mnorden81/CRSF-Multiswitch-ESP32-S3/docs/Projektbeschreibung.docx

# RC-Multiswitch-ESP32-S3

Projektbeschreibung, Stand 18.10.2026, Hardware v0.4 (PCB vom C3 uebertragen)

# Zweck

RC-Multiswitch mit 8 Schaltkanaelen auf einem Waveshare ESP32-S3-Zero.

Gleiche Funktion wie die C3-Variante, aber mit dem ESP32-S3-Zero und einem dritten UART. Das PCB wurde vom C3-Layout uebernommen, die Leitungen am ESP32 sind neu verlegt (DRC steht noch aus).

# Merkmale

- 8 Schaltkanaele ueber ULN2803A, Kontroll-LED je Kanal
- UART A (Eingang), UART B und UART C (Weiterleitung/Erweiterung)
- Versorgung des ESP32 aus +5 V des Empfaengers, Last getrennt mit 5-12 V
- Eigener THT-Footprint fuer den S3-Zero (nur 2x9 Header)

# Hardware

Board: Waveshare ESP32-S3-Zero

## Last und Treiber

- Lastspannung 5-12 V (VLOAD) an CN2 (JST PH 2), TVS-Diode P6KE18A als Schutz.
- Treiber ULN2803A, 8 Kanaele, max. 500 mA je Kanal (Verlustleistung des ULN2803A bei mehreren Kanaelen beachten).
- R9-R16 (THT 1/4 W) zwischen ULN-Ausgang und Stiftleiste J1: Es ist kein Wert vorgegeben. Der Anwender muss die Widerstaende selbst passend zu Verbraucher und Lastspannung (5-12 V) auslegen, Strom und Verlustleistung beachten.
- R1-R8 und LED1-LED8 (3 mm) als Kontroll-LED je Kanal, vom Steuersignal Sn (3,3 V) gegen GND. Auch hier legt der Anwender die Werte selbst fest. Eine Empfehlung fuer die Kontroll-LEDs ist auf der Platine aufgedruckt.
- Keine Pulldowns und keine Widerstaende in den UART-Leitungen. Der ESP32 wird aus +5 V von CN1 (BEC/Empfaenger) versorgt.

## GPIO-Belegung

Funktion | GPIO
S0..S7 | IO11, IO4, IO5, IO6, IO10, IO9, IO8, IO7
UART A (CN1, Eingang) | TX IO43, RX IO44 (UART0)
UART B (J5) | TX IO13, RX IO12
UART C (J6) | TX IO2, RX IO1
Frei | IO3 (Strapping), IO14-IO16 (Loetpads)

## Anschluesse

- CN1, J5, J6: UART A/B/C als JST-GH 4 (Footprint BM04B-GHS-TBT)
- CN2 Last 5-12 V (JST PH 2, max. ca. 2 A je Kontakt)
- J1 Ausgaenge S0..S7

## Hinweise

- UART A liegt auf UART0: beim Booten gibt das ROM ein Log auf IO43 aus.
- Empfehlung LED-Vorwiderstaende R1-R8 bei 3,3 V (ca. 5 mA, auch auf der Platine aufgedruckt): Rot/Gelb 270 R, Gruen 220 R, Blau/Weiss 56 R.
- Footprint ESP32-S3-Zero_THT: 2x9, 2,54 mm, Reihenabstand 15,24 mm. Vor dem Layout 1:1 am echten Board pruefen.

# Firmware (v4.01)

- Arduino-Sketch firmware/RC_Multiswitch, gleicher Quellcode fuer C3 und S3 (Board wird automatisch erkannt). Basis: MultiSwitch_ESP32_V3 v3.12.
- CRSF auf UART A, wahlweise SBUS. Modulkette ueber UART B (und UART C beim S3), Router mit CRC-Pruefung und Sendewarteschlange je Port.
- Jedes Modul der Kette hat eine eigene Adresse (0-15) und ist ueber Lua am Sender und ueber die Web-UI einzeln einstellbar.
- BOOT-Taster 3 s: WLAN-AP ein/aus. Status-LED (nur S3): aus, 500 ms, schnell bei Failsafe, Doppelblitz bei doppelter Adresse.

# Projektstruktur

- hardware/: KiCad-Projekt (Schaltplan, PCB, PDF, eigene Footprints)
- firmware/: Firmware v4.01 (Arduino-Sketch, Details in firmware/README.md)
- docs/: diese Projektbeschreibung
- README.md: Kurzfassung fuer GitHub

# Stand

- Hardware: Schaltplan fertig, PCB vom C3 uebernommen und an U1 neu verlegt. DRC in KiCad steht noch aus, J6 nur vorlaeufig platziert.
- Firmware: v4.01 kompiliert fuer C3 und S3, noch nicht auf Hardware getestet.

# Offene Punkte

- DRC in KiCad ausfuehren (an U1 sind laut PCB-Datei alle Anschluesse verlegt)
- Platzierung von J6 (UART C) festlegen
- Footprint am echten Board pruefen
- Firmware auf Hardware testen (Einzelmodul und Kette mit 2-3 Modulen)

RC-Multiswitch-ESP32-S3 | Seite
