mnorden81/CRSF-Multiswitch-ESP32-S3/hardware/RC-Multiswitch-ESP32-S3.pdf

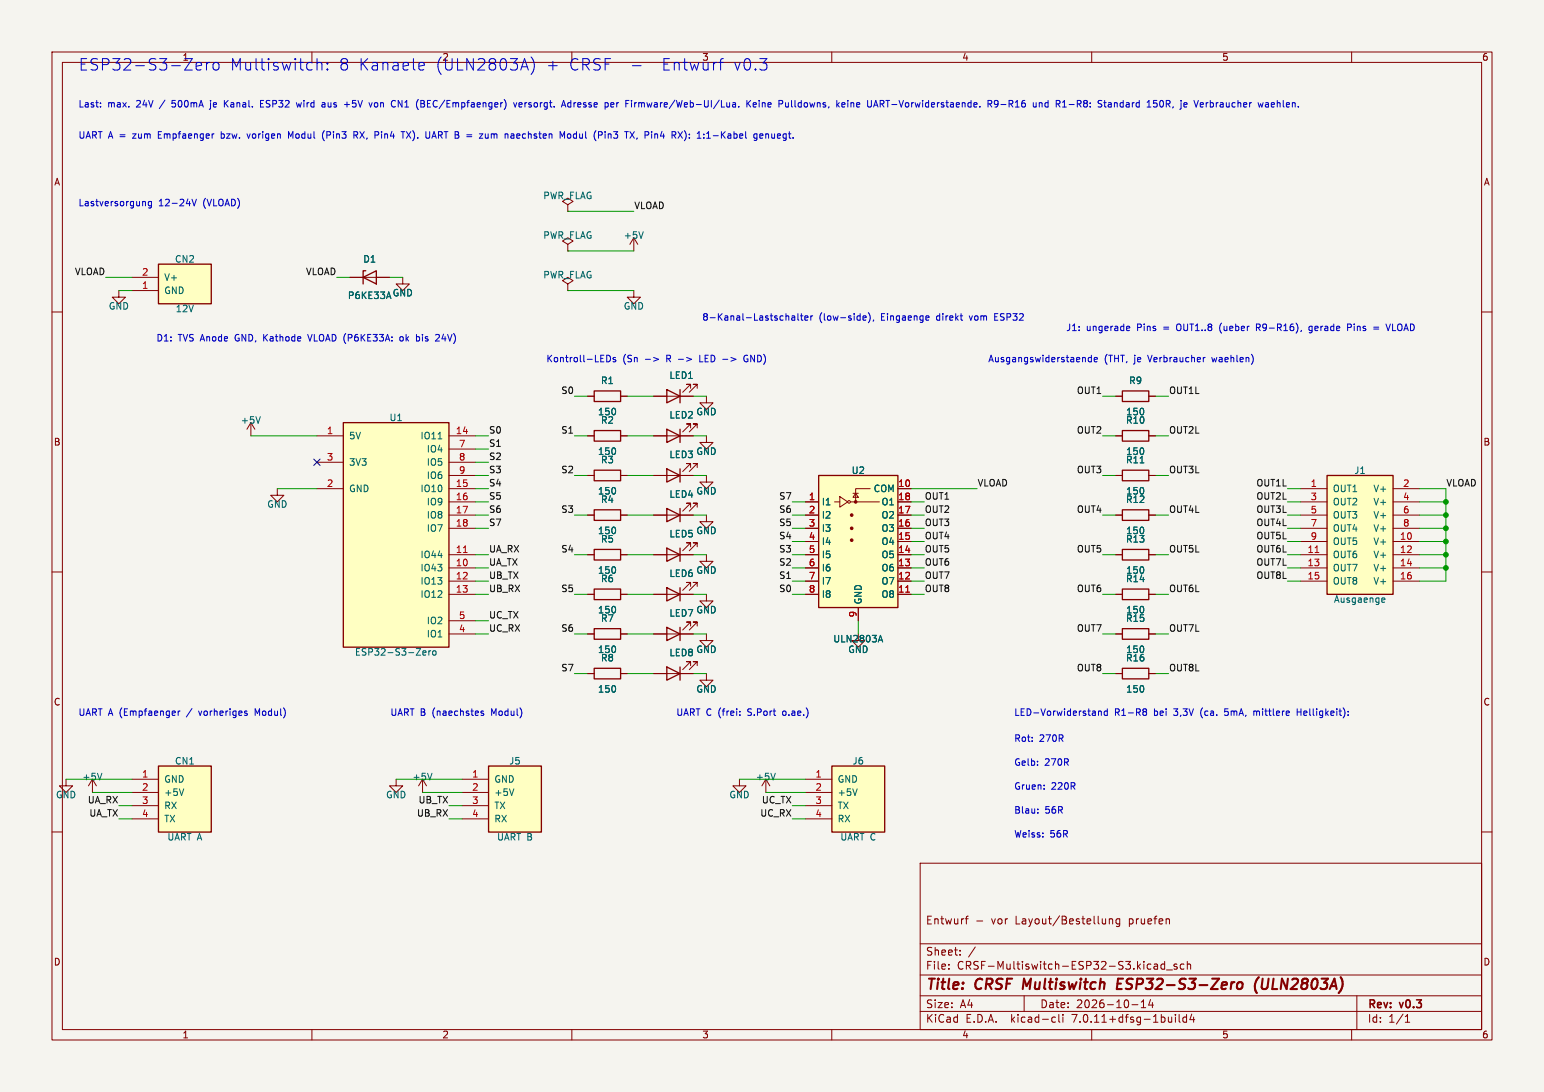
[picture p1: page 1]
