mnorden81/CRSF-Multiswitch-ESP32-S3/hardware/RC-Multiswitch-ESP32-S3.kicad_pcb

## KiCad design hardware/RC-Multiswitch-ESP32-S3.kicad_pcb (2026-10-20)

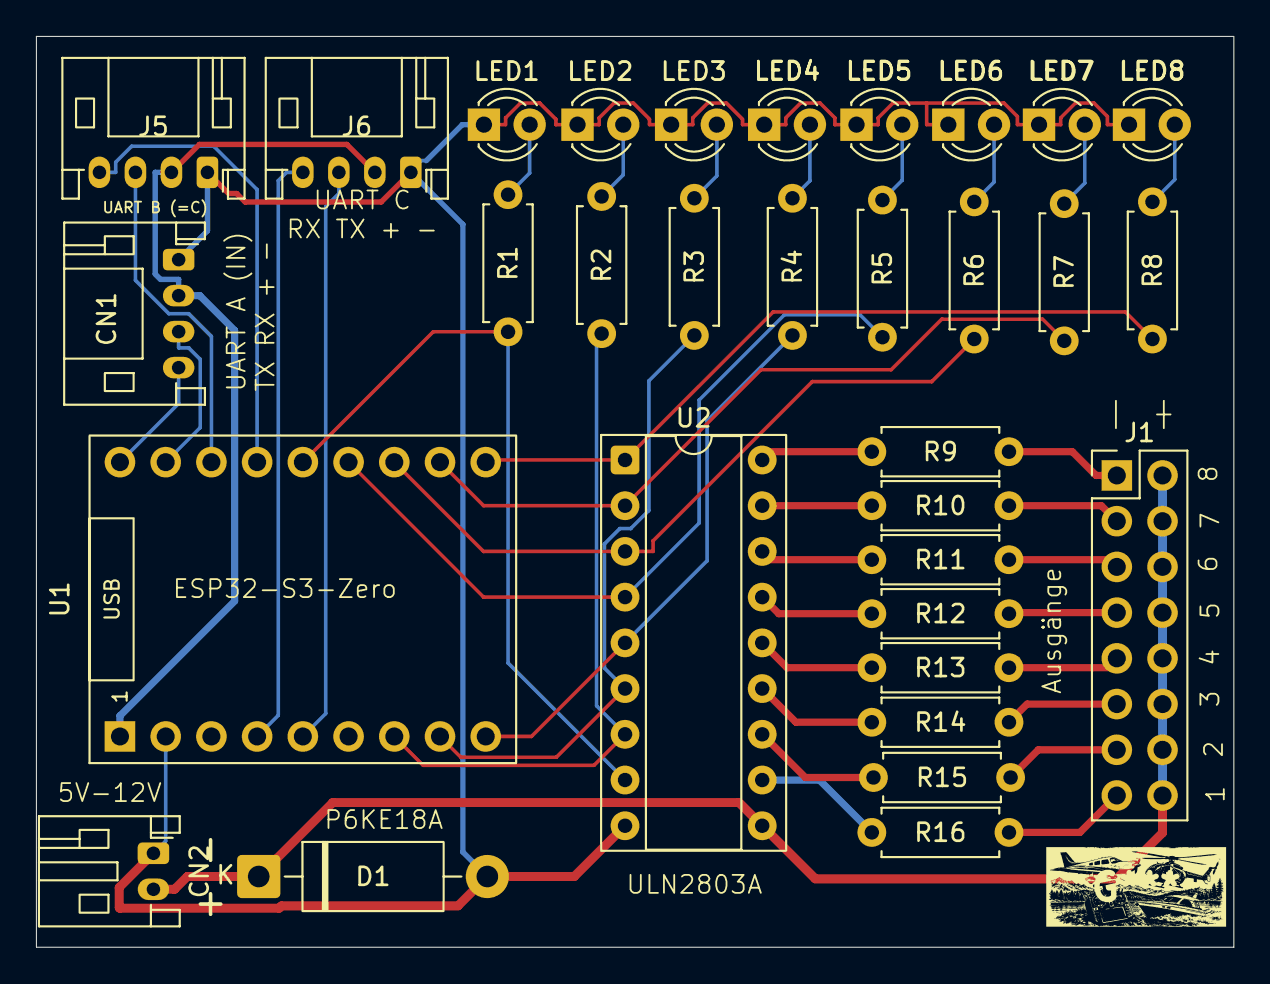
[picture p2: board RC-Multiswitch-ESP32-S3.kicad_pcb from above]

Board: 2 copper layers, 66.5 x 50.6 mm, 32 parts (0 on the bottom side), 41 nets.

Parts:
CN1: UART A; JST_PH_S4B-PH-K_1x04_P2.00mm_Horizontal
CN2: 5-12V; JST_PH_S2B-PH-K_1x02_P2.00mm_Horizontal
D1: P6KE18A; D_DO-15_P12.70mm_Horizontal
J1: Ausgaenge; PinHeader_2x08_P2.54mm_Vertical
J5: J5_UART B; JST_PH_S4B-PH-K_1x04_P2.00mm_Horizontal
J6: UART C; JST_PH_S4B-PH-K_1x04_P2.00mm_Horizontal
LED1, LED2, LED3, LED4, LED5, LED6, LED7, LED8: LED; LED_D3.0mm
R1, R2, R3, R4, R5, R6, R7, R8, R9, R10, R11, R12, R13, R14, R15, R16: R; R_Axial_DIN0207_L6.3mm_D2.5mm_P7.62mm_Horizontal
U1: ESP32-S3-Zero; ESP32-S3-Zero_THT
U2: ULN2803A; DIP-18_W7.62mm_Socket

Connections:
+5V: CN1.2 (+5V), J5.2 (+5V), J6.2 (+5V), U1.1 (5V)
/OUT1: R9.1, U2.18 (O1)
/OUT1L: J1.1 (OUT1), R9.2
/OUT2: R10.1, U2.17 (O2)
/OUT2L: J1.3 (OUT2), R10.2
/OUT3: R11.1, U2.16 (O3)
/OUT3L: J1.5 (OUT3), R11.2
/OUT4: R12.1, U2.15 (O4)
/OUT4L: J1.7 (OUT4), R12.2
/OUT5: R13.1, U2.14 (O5)
/OUT5L: J1.9 (OUT5), R13.2
/OUT6: R14.1, U2.13 (O6)
/OUT6L: J1.11 (OUT6), R14.2
/OUT7: R15.1, U2.12 (O7)
/OUT7L: J1.13 (OUT7), R15.2
/OUT8: R16.1, U2.11 (O8)
/OUT8L: J1.15 (OUT8), R16.2
/S0: R1.1, U1.14 (IO11), U2.8 (I8)
/S1: R2.1, U1.7 (IO4), U2.7 (I7)
/S2: R3.1, U1.8 (IO5), U2.6 (I6)
/S3: R4.1, U1.9 (IO6), U2.5 (I5)
/S4: R5.1, U1.15 (IO10), U2.4 (I4)
/S5: R6.1, U1.16 (IO9), U2.3 (I3)
/S6: R7.1, U1.17 (IO8), U2.2 (I2)
/S7: R8.1, U1.18 (IO7), U2.1 (I1)
/UA_RX: CN1.3 (RX), U1.11 (IO44)
/UA_TX: CN1.4 (TX), U1.10 (IO43)
/UB_RX: J5.4 (RX), U1.13 (IO12)
/UB_TX: J5.3 (TX), U1.12 (IO13)
/UC_RX: J6.4 (RX), U1.4 (IO1)
/UC_TX: J6.3 (TX), U1.5 (IO2)
/VLOAD: CN2.2 (V+), D1.1 (K), J1.2 (V+), J1.4 (V+), J1.6 (V+), J1.8 (V+), J1.10 (V+), J1.12 (V+), J1.14 (V+), J1.16 (V+), U2.10 (COM)
GND: CN1.1 (GND), CN2.1 (GND), D1.2 (A), J5.1 (GND), J6.1 (GND), LED1.1 (K), LED2.1 (K), LED3.1 (K), LED4.1 (K), LED5.1 (K), LED6.1 (K), LED7.1 (K), LED8.1 (K), U1.2 (GND), U2.9 (GND)
unnamed: LED1.2 (A), R1.2
unnamed: LED2.2 (A), R2.2
unnamed: LED3.2 (A), R3.2
unnamed: LED4.2 (A), R4.2
unnamed: LED5.2 (A), R5.2
unnamed: LED6.2 (A), R6.2
unnamed: LED7.2 (A), R7.2
unnamed: LED8.2 (A), R8.2
