mnorden81/CRSF-Multiswitch-ESP32-S3/firmware/RC_Multiswitch/crsf_esp32.h

#ifndef CRSF_H
#define CRSF_H

#include <Arduino.h>
#include "crsf_esp32_protocol.h"

#define CRSF_MAX_CHANNELS 16
#define CRSF_PACKET_SIZE 64

#define BAUD_RATE 420000
#define CHANNEL_MASK 0x07FF

// v4.01: CRSF-Router fuer Modulketten (Spezifikation Kapitel 4)
#define CRSF_ROUTER_QUEUE 8      // Sendewarteschlange je Port (Frames)
#define CRSF_UART_RX_BUF  1024   // UART-Empfangspuffer (Bytes)
#define CRSF_UART_TX_BUF  512    // UART-Sendepuffer (Bytes)

// Ein CRSF-Port des Routers: Empfangs-Parser + Sendewarteschlange.
struct CrsfPort {
    HardwareSerial* ser = nullptr;
    // Parser (Zustand bleibt ueber Aufrufe erhalten)
    uint8_t rx[CRSF_PACKET_SIZE];
    uint8_t rxIdx = 0;
    uint8_t rxLen = 0;
    // Sendewarteschlange (Ringpuffer ganzer Frames)
    uint8_t q[CRSF_ROUTER_QUEUE][CRSF_PACKET_SIZE];
    uint8_t qLen[CRSF_ROUTER_QUEUE];
    uint8_t qHead  = 0;
    uint8_t qCount = 0;
};

class CRSF
{
public:

    CRSF();
    void init_crsf(HardwareSerial *serialPort, uint8_t rxPin, uint8_t txPin);
    void read_packets(uint8_t debug);

    // ── Router (NEU v4.01) ──────────────────────────────────────────────
    // portC darf nullptr sein (C3 hat keinen UART C). Nach init_crsf() aufrufen.
    void init_router(HardwareSerial* portB, uint8_t bRx, uint8_t bTx,
                     HardwareSerial* portC, uint8_t cRx, uint8_t cTx);
    // B/C lesen, nach A weiterleiten, Warteschlangen abarbeiten. Jeden Loop.
    void route_packets();
    uint32_t getFwdDown()    const { return fwdDown; }    // A -> B/C
    uint32_t getFwdUp()      const { return fwdUp; }      // B/C -> A
    uint32_t getFwdDropped() const { return fwdDropped; } // Warteschlange voll
    uint32_t getDownCrcErrors() const { return downCrcErrors; }
    // Device-Info mit eigener Adresse von B/C gesehen = doppelte Adresse
    bool     isDuplicateAddress() const { return duplicateAddress; }
    void send_packets(byte* buffer, size_t length, uint8_t debug);

    void send_rc_channels_packed();
    void send_ping();
    // paramVersion: CRSF "Parameter Version Number" - Default 0 nur fuer
    // Faelle ohne eigene Zaehlung; der Haupt-Aufruf (MultiSwitch_ESP32_V3.ino)
    // uebergibt seit v2.03 die Firmware-Version, siehe dortigen Kommentar
    // (uebernommen aus dem Soundmodul-Projekt, ESP32-RC-Sound v7.18).
    void send_device_info(const char* name, uint8_t parameter, uint8_t paramVersion = 0);
    void send_param_response_CRSF_UINT8(uint8_t param_id, uint8_t parent, const char* name, uint8_t val, uint8_t min, uint8_t max, const char* unit);
    void send_param_response_CRSF_FLOAT(uint8_t param_id, uint8_t parent,  const char* name, uint32_t val, uint32_t min, uint32_t max, uint32_t default_val, uint8_t decimal_point, uint32_t step_size, const char* unit);
    void send_param_response_CRSF_TEXT_SELECTION(uint8_t param_id, uint8_t parent,  const char* name, const char* options, uint8_t val, uint8_t min, uint8_t max);
    void send_param_response_CRSF_STRING(uint8_t param_id, uint8_t parent,  const char* name, const char* value, uint8_t val, uint8_t max_length);
    void send_param_response_CRSF_FOLDER(uint8_t param_id, uint8_t parent, const char* name, std::initializer_list<uint8_t> children);
    void send_param_response_CRSF_INFO(uint8_t param_id, uint8_t parent,  const char* name, const char* info);

    void send_tele_GPS(int32_t latitude, int32_t longitude, uint16_t groundspeed, uint16_t heading, uint16_t altitude, uint8_t satellites);
    void send_tele_Battery_Sensor(uint16_t voltage, uint16_t current, uint32_t capacity_used, uint8_t remaining);
    void send_tele_Vario(uint16_t v_speed);   
    void send_tele_Baro_Altitude(int32_t altitude_dm, int16_t vertical_speed_cm_s);
    void send_tele_Airspeed(uint16_t speed);
    void send_tele_RPM(uint8_t rpm_source_id, std::initializer_list<int32_t> rpm_value);
    void send_tele_Temp(uint8_t temp_source_id, std::initializer_list<int32_t> temperature);
    void send_tele_Voltages(uint8_t voltage_source_id, std::initializer_list<int32_t> voltage_values);
    void send_tele_Attitude(int16_t pitch, int16_t roll, int16_t yaw);

    void send_command_MWSET(uint8_t adress, uint8_t state);
    void send_command_MWSET4(uint8_t adress, uint8_t stateH, uint8_t stateL);
    void send_command_MWSET4M(uint8_t adress_1, uint8_t stateH_1, uint8_t stateL_1, uint8_t adress_2, uint8_t stateH_2, uint8_t stateL_2);
    void send_command_MWPROP(uint8_t adress, uint8_t channel, uint8_t duty );

    void send_param(uint8_t parameter_number, uint8_t data);
    void read_param(uint8_t parameter_number, uint8_t parameter_chunk_number);

    void send_command(uint8_t command_id, std::initializer_list<uint8_t> payload);

    uint16_t get_crfs_channels(uint8_t ch) const { return channels[ch]; }
    uint8_t get_crfs_buffer(uint8_t ch) const { return crfs_buffer[ch]; }
    // Separater Puffer fuer MWSET-Kommandos: beim Empfang gesichert (gegen Ueberschreiben durch Folge-Frames)
    uint8_t get_cmd_buffer(uint8_t ch) const { return cmdBuffer[ch]; }

    bool getDeviceInfoReplyPending() const { return deviceInfoReplyPending; }
    bool getDeviceEntryReplyPending() const { return deviceEntryReplyPending; }
    bool getDeviceReadReplyPending() const { return deviceReadReplyPending; }
    bool getDeviceWriteReplyPending() const { return deviceWriteReplyPending; }
    bool getDeviceCommandReplyPending() const { return deviceCommandReplyPending; }
    uint8_t getPingSource()      const { return pingSource; }
    uint8_t getParamReadIndex()  const { return paramReadIndex; }
    uint8_t getParamWriteIndex() const { return paramWriteIndex; }
    uint8_t getParamWriteValue() const { return paramWriteValue; }
    uint8_t getParamReadSource() const { return paramReadSource; }
    // Eigene CRSF-Geraeteadresse (0xC0..0xCF, abgeleitet aus der WM-Adresse) – uebernommen aus v1.24
    void          setDeviceAddress(uint8_t a) { deviceAddress = a; }
    uint8_t       getDeviceAddress() const { return deviceAddress; }
    unsigned long getPingTime()      const { return pingReceivedTime; }
    void addTxEcho(uint16_t n) { txEchoBytes += n; }

    void setDeviceInfoReplyPending(bool newValue);
    void setDeviceEntryReplyPending(bool newValue);
    void setDeviceReadReplyPending(bool newValue);
    void setDeviceWriteReplyPending(bool newValue);
    void setDeviceCommandReplyPending(bool newValue);

    void set_crsf_channel(uint8_t ch, uint16_t value);

    // ── Diagnose-Zaehler (immer aktiv) ──────────────────────────────────
    // v2.00, uebernommen aus Soundmodul-Projekt: macht "geht nicht" auf der
    // Debug-Seite direkt sichtbar (kommen ueberhaupt Bytes an? gueltige
    // Frames? CRC-Fehler? wird ueberhaupt gepingt?), ohne Seriell-Monitor.
    uint32_t getRawBytesRx()  const { return rawBytesRx; }
    uint32_t getValidFrames() const { return validFramesRx; }
    uint32_t getCrcErrors()   const { return crcErrorsRx; }
    uint32_t getDevicePings() const { return devicePingsRx; }
    uint32_t getParamReads()  const { return paramReadsRx; }
    uint32_t getParamWrites() const { return paramWritesRx; }
    // v4.00: Zeitpunkt (millis) des letzten RC_CHANNELS_PACKED-Frames,
    // 0 = noch keiner. Basis fuer das LED-Muster "Frames da, aber kein RC-Link".
    unsigned long getLastRcFrameMs() const { return lastRcFrameMs; }

private:
    void updateChannels();
    void updateLink_Statistics();
    void updateDevice_Info();
    void print_channels();
    void crsfDataReceive();

    // Router (v4.01)
    static bool isSyncByte(uint8_t b);
    bool parseByte(CrsfPort& p, uint8_t data);   // true = gueltiger Frame in p.rx
    void routeFromA(const uint8_t* f, uint8_t n);
    void routeFromDown(CrsfPort& p);
    void enqueue(CrsfPort& p, const uint8_t* f, uint8_t n);
    void serviceQueue(CrsfPort& p);
    CrsfPort portA_, portB_, portC_;   // portA_ nur Sendewarteschlange
    bool     routerActive  = false;
    uint32_t fwdDown       = 0;
    uint32_t fwdUp         = 0;
    uint32_t fwdDropped    = 0;
    uint32_t downCrcErrors = 0;
    bool     duplicateAddress = false;
    // Parser-Zustand UART A (v4.01: bleibt ueber Aufrufe erhalten)
    uint8_t  rxIdxA = 0;
    uint8_t  rxLenA = 0;

    bool deviceInfoReplyPending;
    bool deviceEntryReplyPending;
    bool deviceReadReplyPending;
    bool deviceWriteReplyPending;
    bool deviceCommandReplyPending;

    uint8_t crfs_buffer[CRSF_PACKET_SIZE];
    uint8_t cmdBuffer[CRSF_PACKET_SIZE] = {0}; // gesicherte Kopie des letzten MWSET-Kommandos
    uint8_t pingSource    = 0xEA;  // Source des letzten DEVICE_PING
    uint16_t txEchoBytes  = 0;     // Gesendete Bytes zum Ueberspringen (Echo-Filter)
    uint8_t paramReadIndex  = 0;   // Angefragter Parameter-Index
    uint8_t paramWriteIndex = 0;   // Zu schreibender Parameter-Index
    uint8_t paramWriteValue = 0;   // Zu schreibender Wert
    uint8_t paramReadSource  = 0xEF; // Source des PARAMETER_READ -> Destination der Antwort
    uint8_t deviceAddress = CRSF_ADDRESS_FLIGHT_CONTROLLER; // eigene CRSF-Adresse (0xC0..0xCF aus WM-Adresse; Default 0xC8)
    unsigned long pingReceivedTime = 0; // Zeitpunkt des letzten Broadcast-Ping (fuer Slot-Delay)
    uint16_t channels[CRSF_MAX_CHANNELS];

    // Diagnose-Zaehler (siehe Getter oben) - v2.00
    uint32_t rawBytesRx    = 0; // jedes vom UART gelesene Byte
    uint32_t validFramesRx = 0; // Frames mit gueltiger CRC (== "frischer Frame da")
    uint32_t crcErrorsRx   = 0; // Frames mit CRC-Fehler
    uint32_t devicePingsRx = 0; // empfangene DEVICE_PING (an uns/Broadcast)
    uint32_t paramReadsRx  = 0; // empfangene PARAMETER_READ (an uns/Broadcast)
    unsigned long lastRcFrameMs = 0; // v4.00, siehe getLastRcFrameMs()
    uint32_t paramWritesRx = 0; // empfangene PARAMETER_WRITE (an uns/Broadcast)
};

#endif
