mnorden81/CRSF-Multiswitch-ESP32-S3/(commit log)

2026-10-16 Ausgangsstand aus KiCad-ZIP vom 2026-10-15
    Hardware nach hardware/, leerer Ordner firmware/, README und .gitignore.
    Claude-Session: https://claude.ai/code/session_017Lns5pPfH18AXUiHEWcrs9
    [CRSF-Multiswitch-ESP32-S3.kicad_pcb, CRSF-Multiswitch-ESP32-S3.kicad_sch]
2026-10-16 Projektbeschreibung in README und docs/Projektbeschreibung.docx
    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
2026-10-16 Hardware-Beschreibung und Firmware-Spezifikation nach docs/
    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
2026-10-16 Firmware v4.00 Schritt 1: Board-Konfiguration C3/S3
    Gleicher Stand wie CRSF-Multiswitch-ESP32-C3 PR #1 (Basis V3 v3.12):
    board_config.h fuer C3/S3, CRSF und SBUS auf UART A, WifiPin entfernt,
    C3-Ausgang 7/8 digital, S3-Status-LED als WS2812, Build fuer C3 und S3.
    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
2026-10-16 Status-LED: Muster nach Spezifikation Kapitel 6
    aus = kein Signal, 500 ms = OK, 100 ms schnell = Failsafe bzw. kein
    RC-Link (CRSF: > 1 s kein Kanal-Frame oder Uplink-LQ 0, SBUS:
    Failsafe-Flag), Doppelblitz = Konfigurationsfehler (g_ledConfigError,
    wird ab Schritt 3 gesetzt). Nur Anzeige, BUS_OK und Ausgaenge
    unveraendert. CRSF merkt sich die Zeit des letzten Kanal-Frames.
    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
    [CRSF_Multiswitch.ino, crsf_esp32.cpp, crsf_esp32.h]
2026-10-16 Status-LED: LedMode-Rueckgabe als uint8_t (Arduino-Prototypen)
    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
2026-10-16 Firmware v4.01: BOOT-Taster fuer WLAN-AP und CRSF-Router fuer Modulketten
    - BOOT-Taster 3 s schaltet den WLAN-AP um (erst nach Loslassen nach dem Boot)
    - Router: A -> B/C ausser Extended-Frames an die eigene Adresse, B/C -> A,
    nie B <-> C; ganze Frames mit CRC-Pruefung, Warteschlange 8 Frames je Port
    - Doppelte Modul-Adresse: Doppelblitz (S3) und Warnung im Debug-Tab
    - Fix: Parser-Zustand UART A bleibt zwischen Loop-Durchlaeufen erhalten
    - UART-Puffer 1024/512 Byte, Router-Zaehler in der Web-UI
    - README und Projektbeschreibung auf v4.01
    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
    [CRSF_Multiswitch.ino, board_config.h, crsf_esp32.cpp, crsf_esp32.h, webui.h]
2026-10-18 Doku: Leitungen an U1 sind in der PCB-Datei bereits verlegt
    Die Angabe '20 offene Verbindungen an U1' stammte aus der Notiz zum
    KiCad-ZIP und passt nicht zur PCB-Datei: jeder belegte U1-Pin hat eine
    Leiterbahn mit passendem Netz. README, README-hardware sowie
    Projektbeschreibung.docx und Hardware-Beschreibung_C3_S3.docx angepasst;
    als offener Punkt bleibt der DRC in KiCad.
    Claude-Session: https://claude.ai/code/session_01DMsk82yDs4uvyAGpWWFEQL
2026-10-18 Umbenennung CRSF-Multiswitch -> RC-Multiswitch
    Neutraler Name, weil der Multiswitch neben CRSF auch SBUS versteht.
    README, docs (MD und DOCX), KiCad-Projekt (Dateinamen, Projekt- und
    Sheet-Verweise, Titel), Sketch-Ordner und CI-Pfad angepasst.
    Geraetename, WLAN-SSID und Config-Export bleiben "MultiSwitch".
    Claude-Session: https://claude.ai/code/session_01Np9GkYmRMGJmd89YiKPa21
    [RC-Multiswitch-ESP32-S3.kicad_pcb, RC-Multiswitch-ESP32-S3.kicad_sch]
2026-10-18 Lokale KiCad-Staende vom 2026-10-17/18 uebernehmen
    Die Arbeit lag nur lokal (nicht auf GitHub) und wurde beim Abgleich
    nach der Umbenennung ueberschrieben. Wiederhergestellt aus
    backups/vor-umbenennung, Dateinamen und Projektverweise auf
    RC-Multiswitch angepasst.
    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
    [RC-Multiswitch-ESP32-S3.kicad_pcb, RC-Multiswitch-ESP32-S3.kicad_sch]
2026-10-18 Lastversorgung CN2 auf 5-12 V, Widerstandswerte entfernt
    - D1 TVS P6KE33A -> P6KE18A (Schaltplan, PCB, Aufdruck)
    - Beschriftung CN2/VLOAD 12-24V -> 5-12V, Aufdruck 5V-24V -> 5V-12V
    - R1-R16 ohne Wert: Anwender legt sie selbst aus, LED-Empfehlung steht auf der Platine
    - Projektbeschreibung, Hardware-Beschreibung, README angepasst
    - ULN2803A und ESP-Versorgung ueber CN1 bleiben unveraendert
    Claude-Session: https://claude.ai/code/session_015ZTAHN4h1MhX6WfGWCfmx3
    [RC-Multiswitch-ESP32-S3.kicad_pcb, RC-Multiswitch-ESP32-S3.kicad_sch]
2026-10-20 PCB: Martins Stand 20.10. (nach Prüfung C3/S3)
    [RC-Multiswitch-ESP32-S3.kicad_pcb]
2026-10-21 v4.02: CRSF-Link-Statistik (LQ) laut Spezifikation korrigieren
    Im Frame 0x14 fehlte das Feld RSSI Antenne 2, dadurch waren alle Felder
    ab LQ um ein Byte verschoben. uplinkLQ war in Wahrheit RSSI Antenne 2,
    die Status-LED zeigte bei Empfaengern mit einer Antenne faelschlich
    "kein RC-Link". Version 4.02 (CRSF Parameter Version Number).
    Claude-Session: https://claude.ai/code/session_01DCSfbUcxwowukecTuzyW8z
    [RC_Multiswitch.ino, board_config.h, crsf_esp32.cpp, crsf_esp32_protocol.h, webui.h]
2026-10-21 v4.03: SBUS-Zeitlimit 10 s
    Kommen 10 s lang keine SBUS-Frames mehr, wird BUS_OK false: Ausgaenge
    gehen aus, WLAN-Auto-Failsafe kann greifen. Vorher blieb ohne Frames
    der letzte Zustand stehen (nur das Failsafe-Bit wurde ausgewertet).
    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
    [RC_Multiswitch.ino, board_config.h, webui.h]
2026-10-21 v4.04: Rolle von UART B/C waehlbar (CRSF, S.Port, GPS)
    Gleicher Firmware-Stand wie RC-Multiswitch-ESP32-C3: UART B und C per Lua
    (Ordner UART B/C, Felder 81-84) und Web-UI auf Aus, CRSF (Modulkette),
    S.Port (FLVSS/MLVSS) oder GPS stellbar, wie beim Soundmodul. Telemetrie
    bei CRSF. TinyGPSPlus im CI.
    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
2026-10-21 CI: TinyGPSPlus 1.0.3 (1.1.0 gibt es im Arduino-Bibliotheksindex nicht)
    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
2026-10-21 v4.05: RC_Common 1.0.0 als gemeinsame Basis
    Gleicher Firmwarestand wie RC-Multiswitch-ESP32-C3:
    - CRSF-Bibliothek 1.1.0 (Router, korrekte Command-CRC) statt eigener Kopie
    - UART B/C: Rollen aus RC_Common (neu Raw), Baudrate je UART
    - Lua-Menue als Tabelle, gleiche Feld-IDs (84/85 = Baudrate B/C)
    - NVS: gemeinsame Schluessel mit einmaliger Uebernahme der alten
    - Status-LED, WLAN-Failsafe, OTA-Upload und JSON-Helfer aus RC_Common
    - CI: RC_Common-Pruefsummen und Host-Tests vor dem Build
    Claude-Session: https://claude.ai/code/session_01MNJVJNBneiqxGnayanzhfn
    [RC_Multiswitch.ino, board_config.h, crsf_esp32.cpp, crsf_esp32.h, crsf_esp32_protocol.h]
2026-10-21 README: Rolle Raw, Baudrate je UART
    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
2026-10-21 GPS-Baudrate "Auto" (RC_Common 1.1.0)
    - RC_Common 1.1.0: gps_autobaud sucht die Baudrate des GPS
    (9600/115200/38400/57600/19200), stellt es auf 115200 Baud und 10 Hz um
    (CASIC/ATGM336H, u-blox M8/M9/M10) und sucht nach 3 s ohne gueltige
    NMEA-Saetze neu. Klappt das Umstellen nicht, bleibt die gefundene Rate.
    - Baudratenliste mit "Auto" als Eintrag 0 (Lua und Web), Vorgabe fuer
    die Rolle GPS; andere Rollen nehmen bei "Auto" ihre Protokoll-Baudrate.
    Alte GPS-Baudraten werden bei der NVS-Uebernahme auf "Auto" gesetzt.
    - /rc_common.js: rcFillBaud() fuer die Baudraten-Auswahl
    - Host-Tests mit simuliertem GPS (tests/test_gps.cpp)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
